ikoTrain/ProduceSense/firmware/ProduceClassifier/model.h

#pragma once
constexpr float MODEL_MU[6]={903.1166667f,937.7361111f,998.0583333f,2458.180556f,2421.177778f,2353.772222f};
constexpr float MODEL_SD[6]={455.9613815f,457.8017894f,456.9919395f,454.1891180f,454.7382707f,452.8084194f};
constexpr float CENTERS[3][6]={{1.368500401f,1.367161299f,1.368003706f,-1.370109640f,-1.367954164f,-1.369079127f},{-0.9316944021f,-0.9339255278f,-0.9310703973f,0.9674628776f,0.9711019517f,0.9655910956f},{-0.4368059988f,-0.4332357708f,-0.4369333083f,0.4026467621f,0.3968522126f,0.4034880315f}};
constexpr int TEST_COUNT=12;
constexpr float TEST_VECTORS[TEST_COUNT][6]={{1597.283333f,1637.583333f,1698.983333f,1786.916667f,1745.783333f,1677.216667f},{1456.916667f,1489.666667f,1547.466667f,1884.866667f,1852.450000f,1790.466667f},{683.5166667f,711.2333333f,763.3500000f,2658.600000f,2627.333333f,2571.566667f},{724.3833333f,767.5666667f,833.4166667f,2623.516667f,2575.950000f,2501.383333f},{572.4666667f,602.9666667f,660.9500000f,2848.733333f,2814.600000f,2748.500000f},{384.1333333f,417.4000000f,484.1833333f,2946.450000f,2910.950000f,2833.500000f},{1591.333333f,1623.266667f,1676.466667f,1742.633333f,1707.166667f,1648.133333f},{1387.133333f,1421.266667f,1484.200000f,1973.833333f,1936.466667f,1869.933333f},{404.7666667f,433.7000000f,498.4333333f,2965.900000f,2936.666667f,2861.733333f},{1507.500000f,1544.433333f,1611.166667f,1843.566667f,1805.633333f,1731.533333f},{621.0333333f,651.7333333f,704.5000000f,2726.066667f,2689.433333f,2629.366667f},{436.4666667f,466.6666667f,526.0666667f,2926.266667f,2892.966667f,2824.366667f}};
constexpr int TEST_EXPECTED[TEST_COUNT]={0,0,2,2,1,1,0,0,1,0,2,1};
